MFHandSimon/electronic-grade-7/README.md

# 电子学会柒级 · 智能小车（ESP32 + RDK X3）

四路 VL53L0X 激光测距 + MPU6050 航向角的小车，做定点 360° 旋转扫描，
把点云拟合成俯视图，验证场地边界。当前已跑通「单点位扫描 → 矩形拟合」。

## 🚀 第一次上手？从这里开始

**零基础同学请按下面顺序看 `docs/` 里的文档，一步步照着做**（约 60 分钟）：

| 步骤 | 文档 | 内容 |
|---|---|---|
| 0 | [docs/00_总览与检查清单](docs/00_总览与检查清单_v1.1.0.md) | 器材清单、**两人分工与时间线**、上电前检查清单 |
| 1 | [docs/01_硬件接线与机械安装](docs/01_硬件接线与机械安装_v1.0.0.md) | 逐根线怎么接、传感器为什么要垫高 |
| 2 | [docs/02_固件烧录](docs/02_固件烧录_v1.0.0.md) | Arduino IDE 配置、烧录、开机信息判读 |
| 3 | [docs/03_RDK上位机](docs/03_RDK上位机_v1.0.0.md) | 装 pyserial、读串口、让车动起来 |
| 4 | [docs/04_扫描与建图](docs/04_扫描与建图_v1.0.1.md) | 转一圈扫描、拟合、出图、判读结果 |
| 5 | [docs/05_排障手册](docs/05_排障手册_v1.0.0.md) | **卡住了先查这里**（18 条现象对照表） |
| 6 | [docs/06_命令速查卡](docs/06_命令速查卡_v1.0.1.md) | 一页纸命令表，可打印 |
| 7 | [docs/07_给AI助教的说明书](docs/07_给AI助教的说明书_v1.0.0.md) | **用 DeepSeek 辅助时，先把这段提示词发给它** |

**三句话抓住重点**：
1. 传感器镜头侧垫高 2–3mm，微微**上仰**——不垫就永远在量地面（读数恒 200–250）
2. 车放场地**中心**，离墙 ≤1m——放角落对角超量程，全是 `-1`
3. 驱动电机的脚本必须 `try/finally` 发 `X`——否则脚本崩了车会一直冲到撞墙

## 目录结构

```
小车控制/
├── docs/                        同学上手指南（00 总览 → 06 速查卡）
├── esp32_scan_field/            主固件 v1.2.0（Arduino IDE 工程）
├── esp32_max_test/              上一代测试固件
├── esp32_*.ino                  各阶段单文件固件（历史留档）
├── rdk_*.py                     RDK X3 端脚本
├── rdk_scripts/                 RDK 上实际使用的脚本（/app 目录同步版）
├── fit_rect.py                  矩形拟合（假设车在场地中心）
├── fit_rect2.py                 矩形拟合（带旋转角+偏移，任意车位）
├── plot_scan.py                 点云俯视图绘制
├── scan360_*.csv                360° 扫描实测数据
├── slow_142210.csv              慢速遍历数据
├── 扫描俯视图_*.png              各轮扫描生成的俯视图
└── 进度与下周计划_v1.0.0.md       完整进度存档与周计划
```

## 硬件

| 项目 | 引脚 / 参数 |
|---|---|
| 左电机 | LEFT_IN1 = GPIO2，LEFT_IN2 = GPIO4 |
| 右电机 | RIGHT_IN1 = GPIO13，RIGHT_IN2 = GPIO27 |
| VL53L0X XSHUT | 前 18(0x30)、后 23(0x31)、左 5(0x32)、右 19(0x33) |
| I2C | SCL = GPIO21，SDA = GPIO22 |
| MPU6050 | I2C 0x68（板载） |
| ESP32↔RDK | GPIO32=RX，GPIO33=TX，115200 8N1，必须共地 |
| RDK 串口 | /dev/ttyS3 |

PWM：20kHz / 8bit，CRUISE_SPEED=128，SPIN_SPEED=140

## 固件命令（v1.2.0）

| 命令 | 作用 |
|---|---|
| W / S / X | 前进 / 后退 / 停 |
| A / D | 原地左转 / 右转 |
| Z | 航向角归零 |
| T | 单次读 → `T:f r b l yaw×10` |
| C / E | 开 / 停流式 → `D:f r b l yaw×10` |
| G | 陀螺探针 |

**注意三点**
1. 电机必须用**慢衰减**（IN1=255、IN2=255-SPEED），快衰减低速没扭矩
2. 数据帧是 **5 个字段**，末尾多了 yaw
3. 串口只能用 pyserial 读，`cat /dev/ttyS3` 读不到

## 关键结论（踩坑换来的）

- **传感器不能有向下俯角**。俯角 11.5° 时地面距离只有 250mm，VL53L0X 优先返回最近物体，墙面永远被地面挡住。把镜头侧垫高 2–3mm 让它微微上仰，问题消失。
- **车必须放在场地中心附近**。放角落时对角距离 1.94m 逼近量程上限，会大量返回 -1。
- **扫描步数 12 步 × 30° = 360°**，写成 24 步会转两圈。
- **串口驱动机器人的脚本必须 try/finally 发 X**，否则脚本崩溃后车会保持最后一条运动指令一直冲。

## 已验证结果

中心位 360° 扫描（48 点），矩形拟合 **1270 × 1480 mm，平均残差 39.8mm**，
与卷尺实测 1.26 / 1.48 m 左右对照，误差在 1cm 以内。

## 复现

```bash
# ESP32 编译（Windows）
arduino-cli compile --fqbn esp32:esp32:esp32doit-devkit-v1 esp32_scan_field

# 绘图（任意机器，无需 matplotlib）
python plot_scan.py scan360_run4.csv --png out.png
python fit_rect.py scan360_run4.csv --png out.png
```
