MFHandSimon/electronic-grade-7/进度与下周计划_v1.0.0.md

# 电子学会柒级小车 —— 进度存档与下周计划

**记录时间**：2026-11-08（周日）
**文档版本**：v1.0.0

---

## 一、项目目标

ESP32（主控 + 电机驱动 + 4 路 VL53L0X + 板载 MPU6050）+ RDK X3（Ubuntu，串口 /dev/ttyS3）
做一台**能自主感知**的小车，最终目标是 **3×3 场地扫描 / 建图**。

当前主线：四向激光测距 + 陀螺仪航向角稳定工作 → 定点 360° 旋转扫描采集 → 数据画成俯视图、验证场地边界。

**今天的状态：主线跑通了。**

---

## 二、硬件与接线（勿改动）

| 项目 | 引脚 / 参数 |
|---|---|
| 左电机 | LEFT_IN1 = GPIO2，LEFT_IN2 = GPIO4 |
| 右电机 | RIGHT_IN1 = GPIO13，RIGHT_IN2 = GPIO27 |
| VL53L0X XSHUT | 前 GPIO18（地址 0x30）、后 GPIO23（0x31）、左 GPIO5（0x32）、右 GPIO19（0x33） |
| I2C 总线 | SCL = GPIO21，SDA = GPIO22 |
| 板载 MPU6050 | I2C 0x68，WHO_AM_I(0x75)=0x68 |
| ESP32 ↔ RDK 串口 | GPIO32 = RX，GPIO33 = TX，115200 8N1，**必须共地** |
| RDK 串口设备 | /dev/ttyS3 |

**PWM 参数**：FREQ = 20000，RES = 8，CRUISE_SPEED = 128，SPIN_SPEED = 140，TIMING_BUDGET_US = 20000，STREAM_PERIOD_MS = 100（约 10Hz）

### 电机驱动必须是「慢衰减」——不要回退

- 正转：IN1 = 255，IN2 = 255 - SPEED
- 反转：IN2 = 255，IN1 = 255 - SPEED
- 停止：全 0

原因：DRV8837 用快衰减模式（IN1=PWM、IN2=0）在低 PWM 下电流快速衰减、扭矩不足，表现为「一冲即停」。这是今天最关键的排障成果。

---

## 三、固件 v1.2.0

文件：`C:\Users\Administrator\Desktop\电子学会柒级\小车控制\esp32_scan_field\esp32_scan_field.ino`

编译：`esp32:esp32:esp32doit-devkit-v1`（已通过，352339 bytes / 26%，RAM 24944 / 7%）

| 命令 | 作用 | 返回 |
|---|---|---|
| W / S / X | 前进 / 后退 / 停 | K |
| A / D | 原地左转 / 右转 | K |
| Z | 航向角归零 | YAW:0.0 |
| T | 单次读四路 + 航向 | T:f r b l yaw×10 |
| C / E | 开 / 停流式 | D:f r b l yaw×10 |
| G | 陀螺探针 | GYRO: 0x68 r75=.. |
| 其他 | 未知指令 | K |

**注意：数据帧是 5 个字段（末尾多了 yaw×10）**，脚本解析写 4 个字段会崩。

---

## 四、RDK 侧环境

- 串口 /dev/ttyS3，115200
- **`cat /dev/ttyS3` 读不到数据**，必须用 pyserial；先开监听再按 RST 才能抓到开机信息
- 脚本放在 /app/ 下，用户粘贴创建

---

## 五、已解决的坑（按时间顺序，共 7 个）

1. **电机低速不转 / 一冲即停** → DRV8837 快衰减扭矩不足，改慢衰减模式解决（已联网核实 TI E2E 论坛）。
2. **前向传感器初始化失败后死等，看门狗循环重启** → 加 okF/okB/okL/okR 布尔保护，失败路直接返回 -1 且不碰总线。另外库函数真名是 `setMeasurementTimingBudgetMicroSeconds`。
3. **开机信息发不出去** → `RDK.begin()` 必须移到 setup() 最前面。
4. **前向 I2C 找不到** → 排线没插严，重新插拔后四路地址 0x30/0x31/0x32/0x33 全 OK。
5. **所有读数卡在 250mm** → 四路传感器**俯角约 11.5°，量的是地面**。VL53L0X 优先返回视场内最近物体，墙面永远排在地面后面。**解法：把镜头那一侧垫高 2–3mm 让传感器微微上仰**，地面反射落到量程外。这一条解决了今天所有问题。
6. **脚本崩溃导致车一直冲到撞墙** → 串口控制无人机时，脚本异常退出会把最后一条 W 留在固件里。**必须 try/finally 兜底发 X** + 限时 + 距离急停。
7. **360° 扫描转两圈** → 步数写成 24 步 × 30° = 720°，正确是 **12 步 × 30° = 360°**。

---

## 六、今天已验证的成果

### 成果 1：中心位 360° 扫描 → 房间矩形拟合成功

- 数据：`scan360_run4.csv`（12 个航向 × 4 路 = 48 个有效点）
- 拟合：**1270 × 1480 mm，平均残差 39.8mm**
- 卷尺实测：**1.26 / 1.48 m** → 误差 1cm 以内
- 图：`扫描俯视图_v1.2.0.png`（蓝点实测、绿框拟合、红点小车）

**这是整个任务最难的一步，已通过。**

### 成果 2：角落位验证 —— 发现量程边界

- 数据：`scan360_corner.csv`，拟合 1303 × 884 mm（尺寸偏小）
- 原因：车放角落时对角距离 √(1.48²+1.26²) = **1.94m**，逼近 VL53L0X 实际量程上限，48 个采样里有 **7 个返回 -1**
- 结论：**单点扫描必须把车放在中心附近（离任一面墙 ≤ 1m）**

### 关键实测参数

| 项目 | 数值 |
|---|---|
| 陀螺仪精度 | 2.5s 原地右转积分 887°，目测 2.4 圈，误差约 2.6% |
| 全速前进 | 约 0.31 m/s（CRUISE_SPEED=128） |
| 脉冲低速 | 走 0.3s 停 0.15s，约 0.2 m/s |
| 矩形拟合残差 | 37–40 mm |

---

## 七、下周计划（按顺序做，每步都有判据）

### Step 0 · 开工检查（5 分钟）

1. ESP32 通电，RDK 上跑一次读数，确认四路都返回合理值（不是 -1、不是 8191）
2. 确认传感器仍然微微上仰（搬动后容易碰歪）
3. 判据：车在中心位时四路读数都在 600–1000mm

### Step 1 · 复现基准（15 分钟）

```bash
python3 /app/s360.py && cat /app/s360_*.csv | tail -14
```

判据：拟合结果在 1270×1480 ±80mm 内。跑不到就说明硬件被动过了，先回到 Step 0。

### Step 2 · 角点提取（30 分钟，纯软件）

从拟合的矩形算出四个顶点坐标、边长、对角线，打印成结构化数据。
判据：能输出「A(0,0) B(1270,0) C(1270,1480) D(0,1480)」这类可直接用于导航的坐标。

### Step 3 · 多站位拼接（核心，约 1 小时）

1. 车在场地内挪 4 个位置（中心 + 三个偏移约 0.3m 的点），每点离墙都不小于 0.6m
2. 每个位置跑 `s360.py` 扫一圈，记录该站位的陀螺仪 yaw
3. 用航向角把各站位的点云旋转、平移，叠加到同一坐标系

判据：叠加图上四面墙重合、不出现重影（偏差 <100mm 算合格）。

**技术要点**：没有编码器，站位间距靠两件事保证——F 读数闭环（走到离墙固定距离停）+ 陀螺仪航向。误差会累积，站位不要超过 5 个。

### Step 4 · 航向闭环走直线（视需要，约 1 小时）

目前开环直走会右偏（左右轮阻力不同，属正常）。需要精确路径时加 MPU6050 航向 PID 差速修正。
判据：直线走 1m，末端航向偏差 <3°。

### 可选 · 报告素材

- 场地俯视图（单点 + 多站位两版）
- 拟合尺寸 vs 卷尺实测对照表（这是最有力的证据）
- 踩坑记录（尤其「俯角量地面」这一条，是硬件+算法结合的典型案例）

---

## 八、文件清单

本地目录：`C:\Users\Administrator\Desktop\电子学会柒级\小车控制\`

| 文件 | 说明 |
|---|---|
| `esp32_scan_field\esp32_scan_field.ino` | 主固件 v1.2.0 |
| `scan360_run4.csv` | 中心位原始数据（48 点，拟合成功那组） |
| `scan360_corner.csv` | 角落位原始数据（含 7 个 -1） |
| `扫描俯视图_v1.2.0.png` | 中心位俯视图（拟合 1270×1480） |
| `扫描俯视图_角落位_v1.3.0.png` | 角落位俯视图 |
| `fit_rect.py` | 矩形拟合（假设车在中心） |
| `fit_rect2.py` | 矩形拟合（带旋转角 + 偏移，任意车位可用） |
| `plot_scan.py` | 点云俯视图绘制（支持 --fr 只用 F/R、--min 过滤近距） |
| `slow_142210.csv` | 慢速遍历数据（证明 F 能测 1m 外墙面） |

RDK 侧（/app/）：`s360.py`（12 步一圈扫描）、`step_scan.py`（开到离墙 550mm 再扫）、`slowrun.py`（慢速遍历）

---

## 九、已知风险

| 风险 | 应对 |
|---|---|
| 传感器被碰歪，俯角回来 | 每次开工先跑 Step 0 检查，读数 <400 就是又量地面了 |
| 障碍物黑色 / 绒面 / 玻璃读不到 | 场地墙面保持灰、红、绿等浅色哑光 |
| 阳光直射环境红外干扰 | 拉窗帘，避开靠窗位置 |
| 陀螺仪累积漂移 | 每圈扫描前发一次 Z 归零 |
| 脚本崩溃导致撞墙 | 所有运动脚本必须 try/finally 发 X，并设限时 |
| 角落地位置程不足 | 站位离墙不超过 1m |

---

## 十、下次开工第一句话该做什么

> 「继续建图」——然后按 Step 0 → Step 1 复现基准 → Step 3 多站位拼接的顺序推进。

---

*文档结束。所有结论均基于 2026-11-08 实测数据。*
