MFHandSimon/electronic-grade-7/扫描俯视图_v1.2.0.png

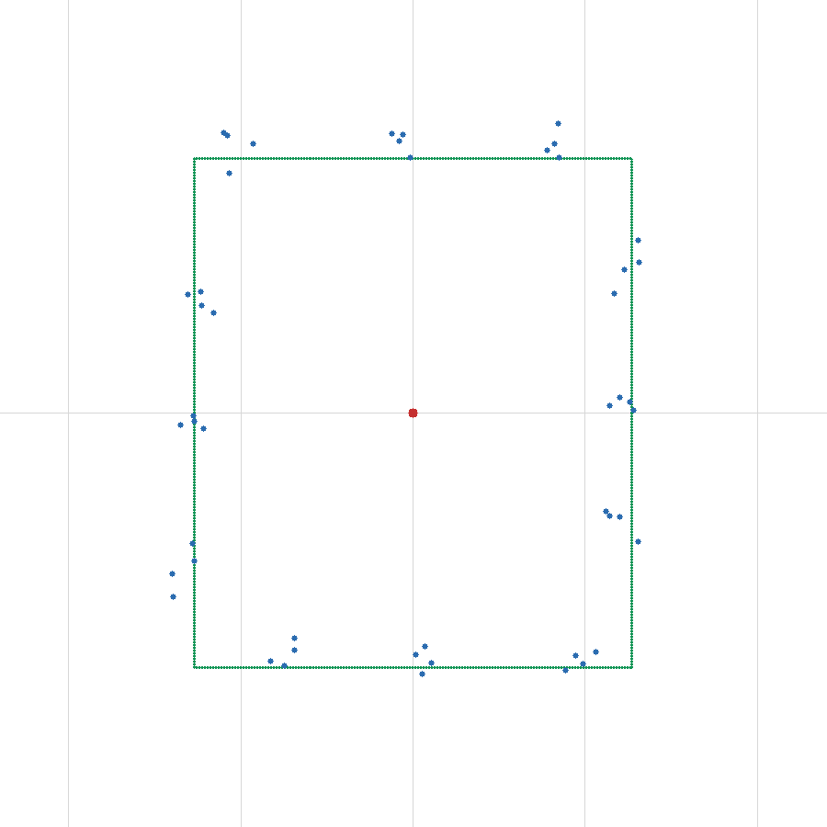
扫描俯视图_v1.2.0.png
