MFHandSimon/electronic-grade-7/扫描俯视图_角落位_v1.3.0.png

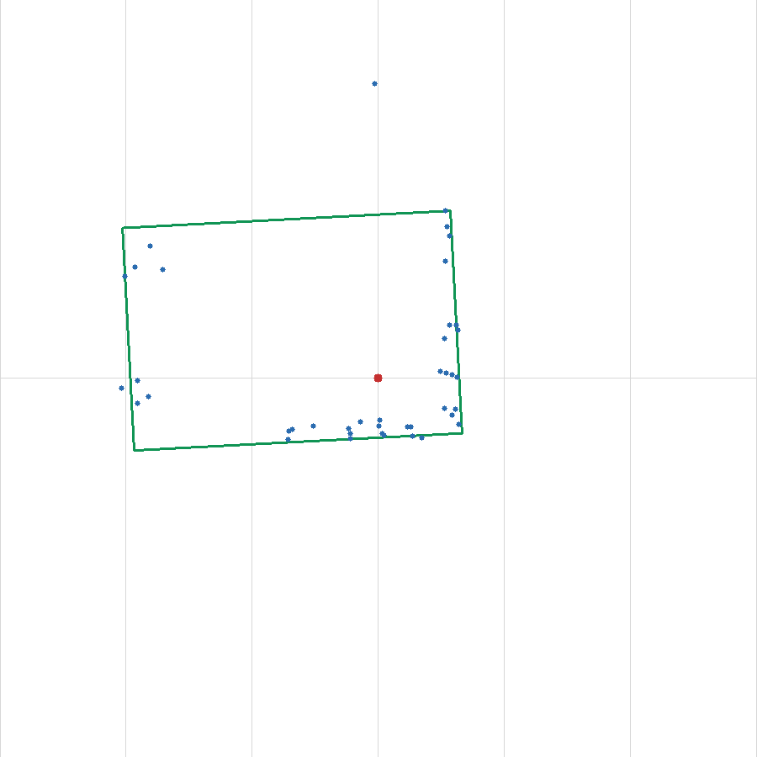
扫描俯视图_角落位_v1.3.0.png
