MFHandSimon/electronic-grade-7/scan360_test.csv

yaw | f | r | b | l
6.9 | 1025 | 1126 | 320 | 254
15.1 | 895 | 900 | 322 | 265
23.3 | 548 | 423 | 339 | 283
29.9 | 424 | 344 | 346 | 309
37.3 | 338 | 358 | 364 | 337
44.3 | 301 | 399 | 317 | 329
51.6 | 254 | 448 | 354 | 351
58.9 | 224 | 546 | 433 | 393
66.6 | 210 | 821 | 8191 | 377
73.7 | 185 | 1072 | 981 | 363
79.9 | 188 | 1137 | 1154 | 349
87.2 | 179 | 1120 | 1223 | 348
94.0 | 180 | 1114 | 1115 | 349
101.4 | 192 | 1083 | 897 | 355
108.5 | 203 | 890 | 563 | 366
115.7 | 226 | 609 | 334 | 369
123.1 | 252 | 477 | 309 | 401
130.0 | 292 | 411 | 330 | 362
136.6 | 281 | 364 | 375 | 321
144.0 | 316 | 321 | 432 | 444
151.0 | 352 | 300 | 540 | 448
157.8 | 327 | 276 | 786 | 774
164.7 | 313 | 273 | 1032 | 1116
172.3 | 301 | 259 | 1058 | 1250
