MFHandSimon/electronic-grade-7/操作日志_v1.0.0.md

# 操作日志（2026-11-08 调机全过程）

按时间顺序记录当天每一次动作、命令与结论，便于复盘和答辩引用。

---

## 阶段一：电机低速调试

| 现象 | 排查 | 结论 |
|---|---|---|
| PWM=255 全速两轮都转，太快 | — | 降速 |
| PWM 降到 128 后不转 | 加 kickStart（先 255 冲 100ms 再降 128） | 变成「冲刺然后不动」 |
| 冲刺即停 | 联网查 DRV8837 数据手册与 TI E2E 论坛 | **快衰减模式低速电流衰减太快、扭矩不足** |

**改法**：切慢衰减模式（PWM 那脚常高，另一脚写 255-speed）
- 正转：IN1=255，IN2=255-CRUISE_SPEED
- 反转：IN2=255，IN1=255-CRUISE_SPEED

结果：CRUISE_SPEED=128 直接能转，用户确认「非常好」。

参考：
- https://e2e.ti.com/support/motor-drivers-group/motor-drivers/f/motor-drivers-forum/218846/drv8837
- https://seekmos.com/post/136.html
- https://www.ti.com.cn/cn/lit/ds/symlink/drv8837.pdf

---

## 阶段二：固件迭代

路径：`esp32_scan_field/esp32_scan_field.ino`

| 版本 | 内容 |
|---|---|
| v1.0.0 | 加连续流式测距 C/E，帧格式 `D:f r b l` |
| v1.0.1 | 传感器初始化失败后仍访问总线导致看门狗循环重启 → 加 okF/okB/okL/okR 保护；修正库函数名为 `setMeasurementTimingBudgetMicroSeconds` |
| v1.0.2 | 加分段 I2C 扫描 `scanBus()`，定位前向模块断在哪一环 |
| v1.1.0 | 加 `gyroProbe()`，读 0x68 的 0x75/0x00/0x0F 识别芯片 |
| v1.2.0 | MPU6050 航向角：解除睡眠、±500dps、DLPF、200 样本零偏标定；`gyroPoll()` 积分 yaw；新增 A/D 原地转向、Z 归零；T 帧改为 5 字段 |

编译结果：352339 bytes / 26%，RAM 24944 / 7%，烧录成功。

---

## 阶段三：串口通信排障

| 问题 | 原因 | 解决 |
|---|---|---|
| `cat /dev/ttyS3` 读不到 | 没设波特率 | 改用 pyserial |
| `echo "T" > /dev/ttyS3 && cat` 无输出 | 时序问题，先发后监听 | 先开监听再按 RST |
| 开机信息发不出来 | `RDK.begin()` 写在 VL53L0X 初始化之后 | 移到 setup() 最前面 |
| 回「? 未知指令: T」 | RDK 脚本的 CMD_NAME 表没收录 T | 更新脚本 |

---

## 阶段四：四路 VL53L0X 排查

1. 第一次 T 无数据 → 脚本不认 T、串口没配波特率
2. 6 秒抓包只看到 `VL F FAIL / VL B OK / L OK / R OK` 且反复出现 → **循环重启**
3. `BUS` 分段扫描输出：
   - `all_off: 68`（板载 MPU6050，意外收获）
   - `F_on: 29 68` → F 初始化成功
   - `final: 30 31 32 33 68` → 四路全 OK（重插前向排线后恢复）

---

## 阶段五：场地扫描尝试（多轮失败）

| 轮次 | 做法 | 结果 | 原因 |
|---|---|---|---|
| 1 | go 模式前进采集 35 帧 | F 1272→184 触发急停 | 防撞逻辑正常；推算速度 0.31 m/s |
| 2 | s360 第一版（24 步） | 只转到 172° | 步数 bug + `readT()` 返回 None 就 break |
| 3 | 半圈数据验证几何 | 拼出一条整齐竖直墙 | **证明极坐标变换算法正确** |
| 4 | 24 步转两圈（725.7°） | 只有车周散点 | 步数 24×30=720 |
| 5 | 12 步一圈（361.7°） | 全在 40cm 内 | 传感器量地面 |
| 6 | 举高 1m 复测 | F/R 全 -1，L 仍 600-800 | **确认俯角过大，地面 250mm 假点** |

---

## 阶段六：慢速遍历

脚本 `slowrun.py`：走 0.3s 停 0.15s，平均约 0.2m/s。

- 第一次跑：帧是 5 字段，脚本按 4 个解析 → 崩在第一帧，固件停在 W，车撞墙轮子继续转
- 修复：`try/finally` 兜底发 X + 25 秒限时 + F<220 急停
- 第二次跑（`slow_142210.csv`）：F 1079 → 205 平滑下降，证明**前方 1m 的墙能读到**；B 恒定 183、L 恒定 241 → 这两路仍卡地面

---

## 阶段七：传感器调平 + 成功建图

1. 把镜头侧垫高 2–3mm，让传感器微微上仰
2. 车放场地中心，`python3 /app/s360.py`（12 步一圈）
3. 读数从 200–250 变为 **573–983**，全部有效
4. `fit_rect.py` 拟合：**1270 × 1480 mm，残差 39.8mm**
5. 与卷尺实测 1.26 / 1.48 m 对照 → **误差 1cm 以内**
6. 车放右上角再扫（`scan360_corner.csv`）：拟合 1303×884，48 个采样里 7 个 -1
   → 对角 1.94m 逼近量程上限，**结论：车必须放中心附近**

---

## 关键数字汇总

| 项目 | 数值 |
|---|---|
| 陀螺仪精度 | 2.5s 转 887°，目测 2.4 圈，误差 2.6% |
| 全速前进 | 0.31 m/s |
| 脉冲低速 | 约 0.2 m/s |
| 拟合残差 | 37–40 mm |
| 有效量程 | 实际 1.2m 内可靠，1.9m 开始丢数据 |
