MFHandSimon/electronic-grade-7/(commit log)

2026-11-13 初始提交：ESP32+RDK 智能小车四路激光扫描建图（v1.2.0 + 扫描/拟合脚本 + 实测数据 + 进度文档）
    [scan360_corner.csv, scan360_run2.csv, scan360_run3.csv, scan360_run4.csv, scan360_test.csv, slow_142210.csv]
2026-11-13 加入 GitHub 推送脚本与操作日志
2026-11-13 新增 docs 上手指南（6篇）：总览/接线/烧录/RDK/扫描建图/排障/速查卡，README 加入导航
2026-11-13 docs/00 总览改为两人分工（A 硬件 / B 软件 + 6 个交接点），版本升至 v1.1.0
2026-11-13 实测尺寸表述改为近似值（1.26/1.48 m 左右），04、06 升至 v1.0.1
2026-11-13 新增 docs/07 给 AI 助教的说明书（DeepSeek 提示词 + 事实卡 + 防瞎编对照表）
